AliDismail/Control-Farm/Version 1/brain storming/Instru Project Brain storming.pdf

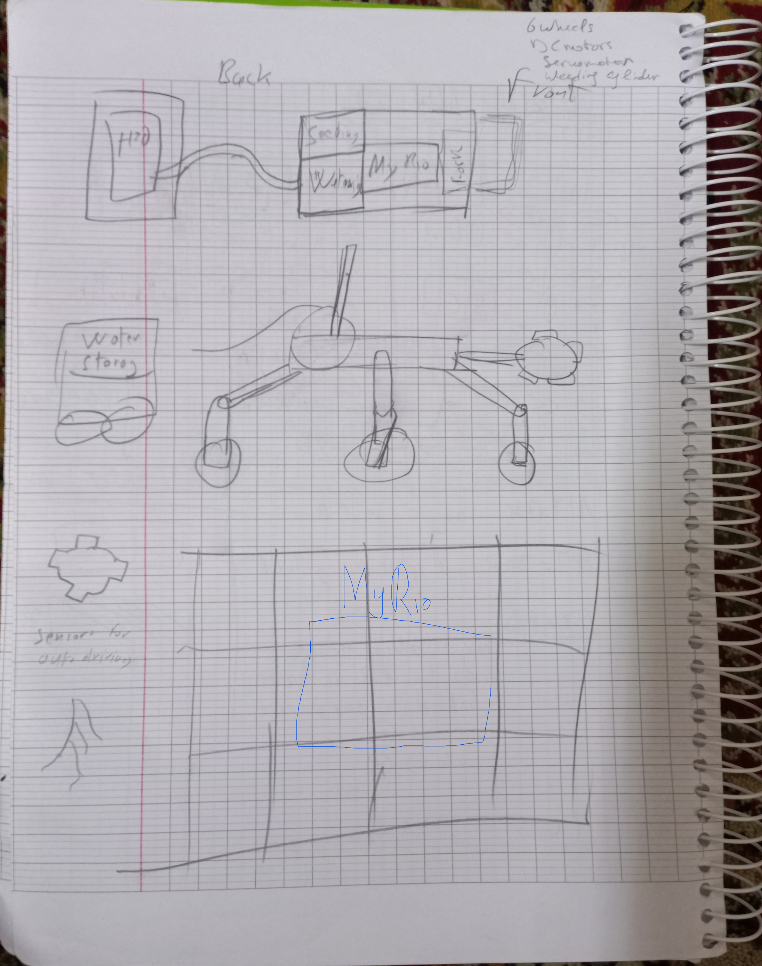
[picture p23: page 1]
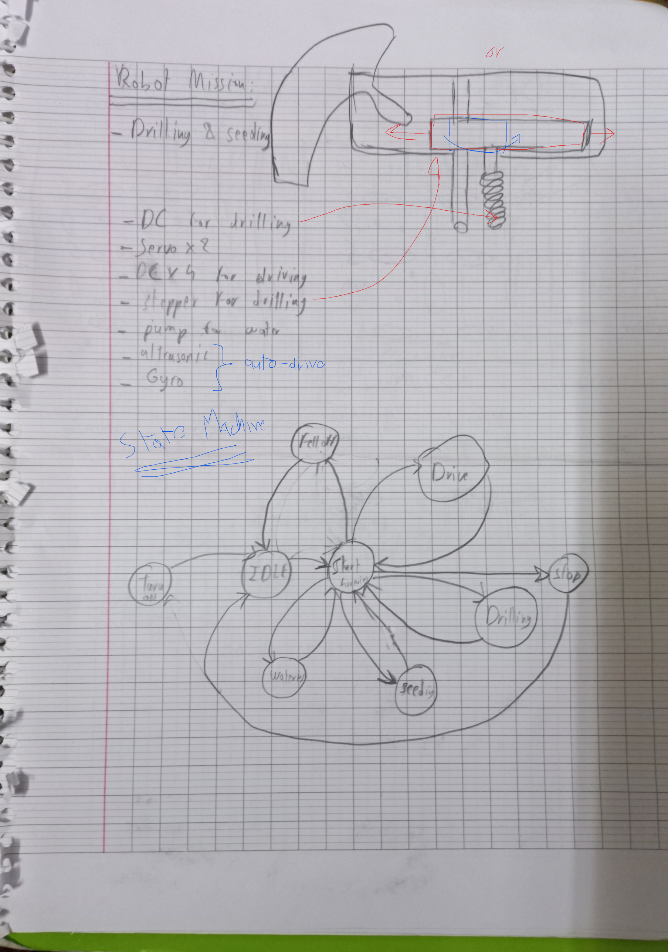
[picture p24: page 2]
