AliDismail/Control-Farm/Version 2/Parts/rest stl/rest stl/Main Gear Shrinked stl.STL

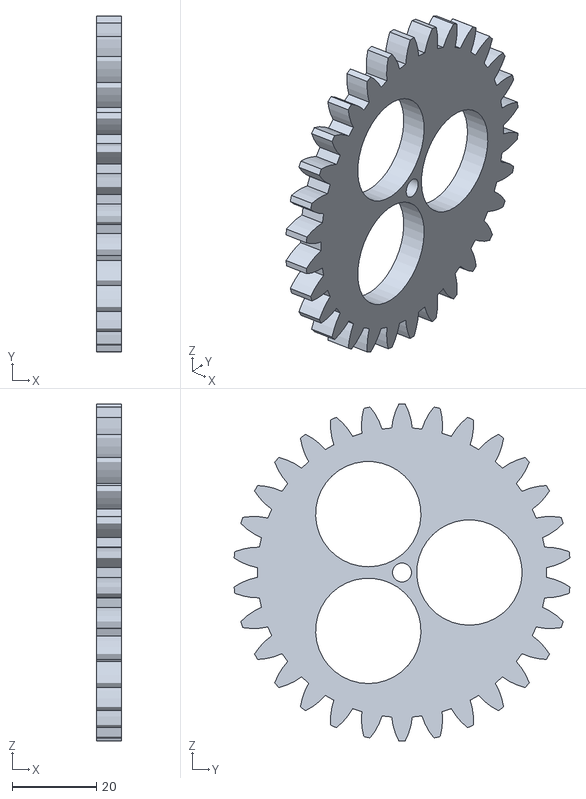
[picture p25: CAD file, 2025-11-14]
Version 2/Parts/rest stl/rest stl/Main Gear Shrinked stl.STL
6.00 x 79.7 x 80.0
