AliDismail/Control-Farm/Version 2/Parts/big/big/Water Stand Shrinked.SLDPRT

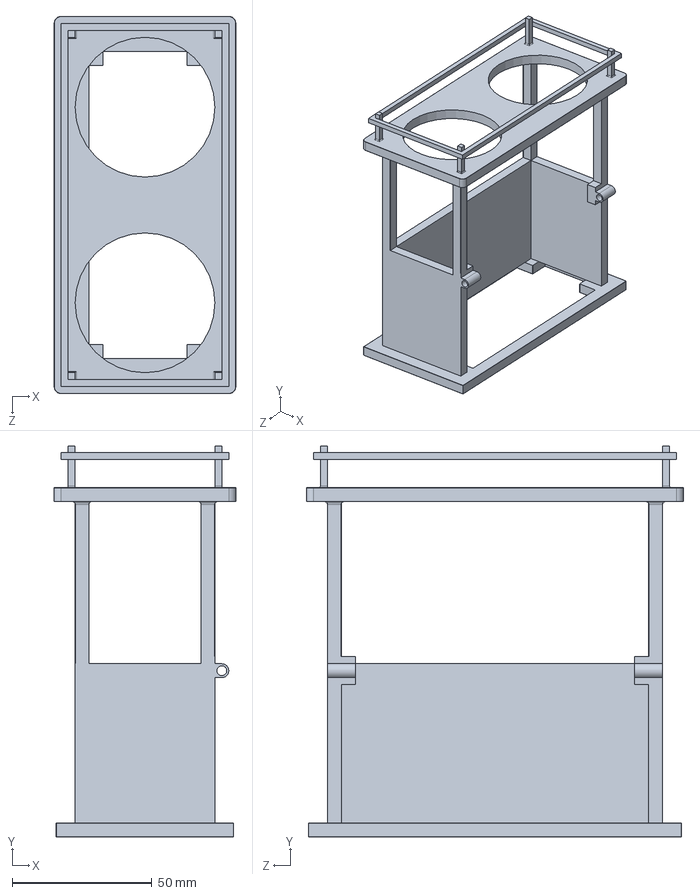
[picture p26: CAD file, 2025-11-14]
Version 2/Parts/big/big/Water Stand Shrinked.SLDPRT
65.0 x 139.9 x 135.0 mm
