AliDismail/Control-Farm/Version 2/Parts/rest stl/rest stl/smallest gear Shrinked stl.STL

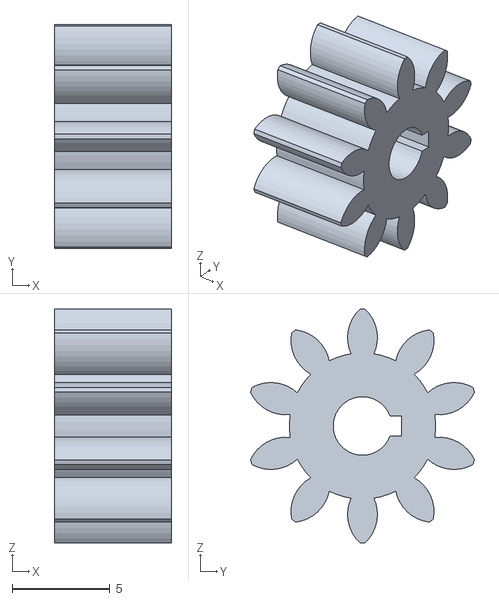
[picture p27: CAD file, 2025-11-14]
Version 2/Parts/rest stl/rest stl/smallest gear Shrinked stl.STL
6.00 x 11.5 x 12.0
