AliDismail/Control-Farm/Version 2/Parts/big/big/Rocker shrinked.SLDPRT

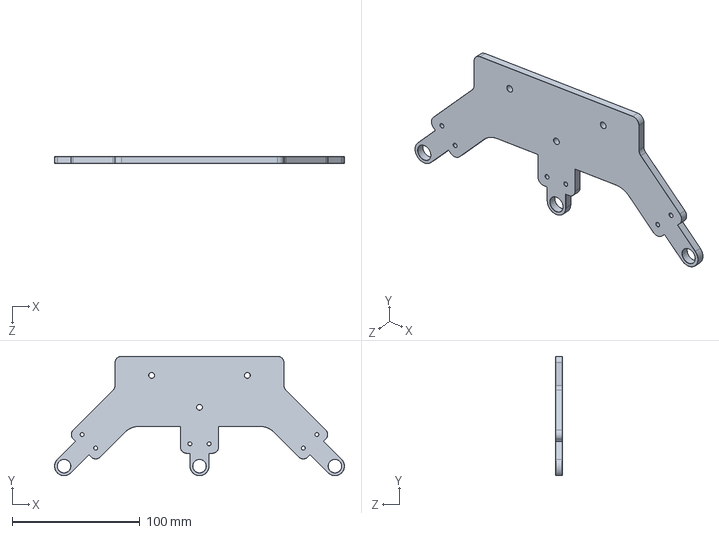
[picture p28: CAD file, 2025-11-14]
Version 2/Parts/big/big/Rocker shrinked.SLDPRT
227.1 x 93.6 x 5.25 mm
