AliDismail/Control-Farm/Version 2/Parts/rest stl/rest stl/Door Shaft Shrinked stl.STL

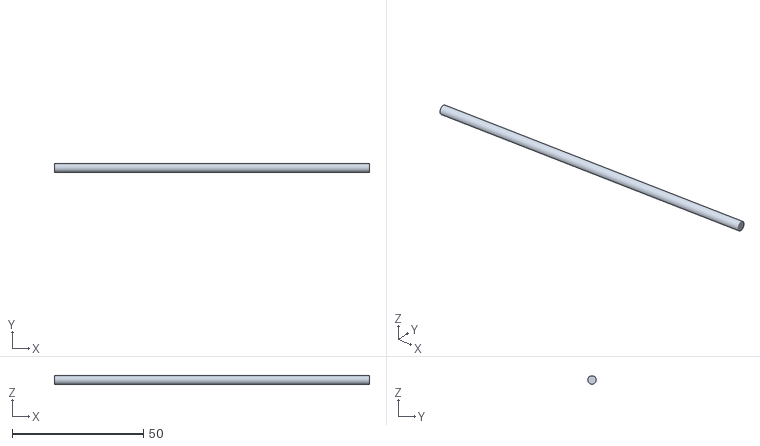
[picture p29: CAD file, 2025-11-14]
Version 2/Parts/rest stl/rest stl/Door Shaft Shrinked stl.STL
120.0 x 3.25 x 3.25
