AliDismail/Control-Farm/Version 2/Parts/big/big/Wheel.SLDPRT

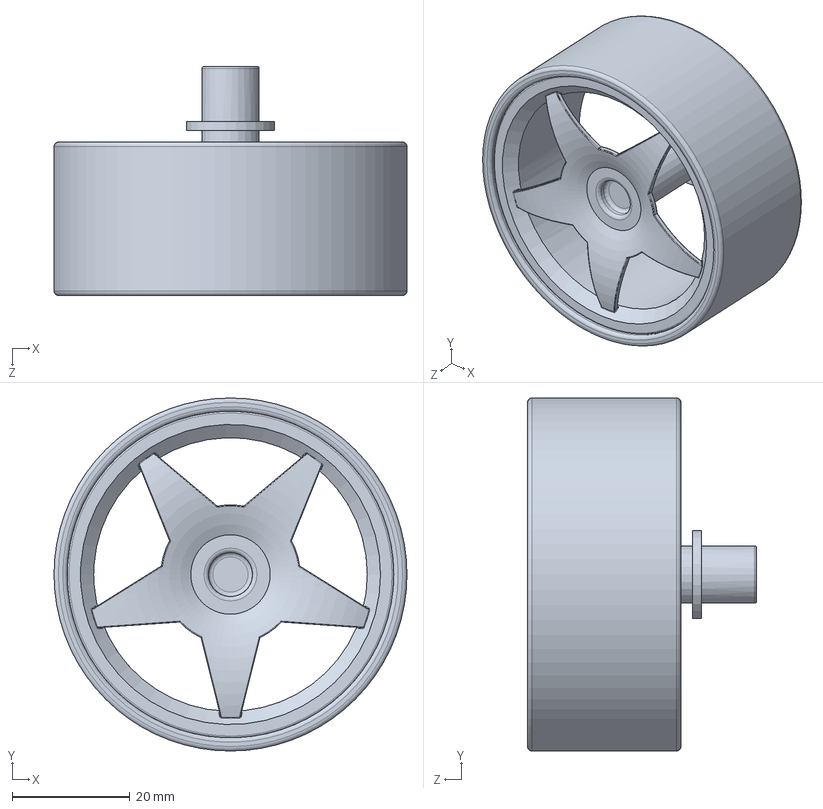
[picture p30: CAD file, 2025-11-14]
Version 2/Parts/big/big/Wheel.SLDPRT
60.0 x 60.0 x 38.9 mm
