AliDismail/Control-Farm/Version 2/Parts/rest stl/rest stl/lower power gear stl.STL

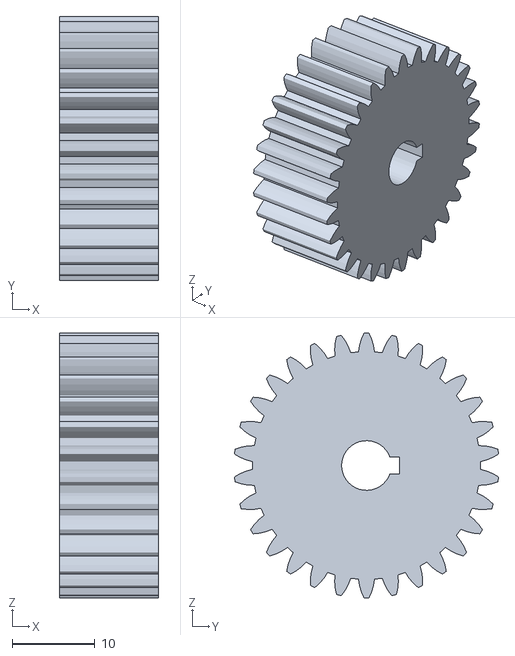
[picture p31: CAD file, 2025-11-14]
Version 2/Parts/rest stl/rest stl/lower power gear stl.STL
12.0 x 31.9 x 32.0
