AliDismail/Control-Farm/Version 2/Parts/big/big/platform base shrinked.SLDPRT

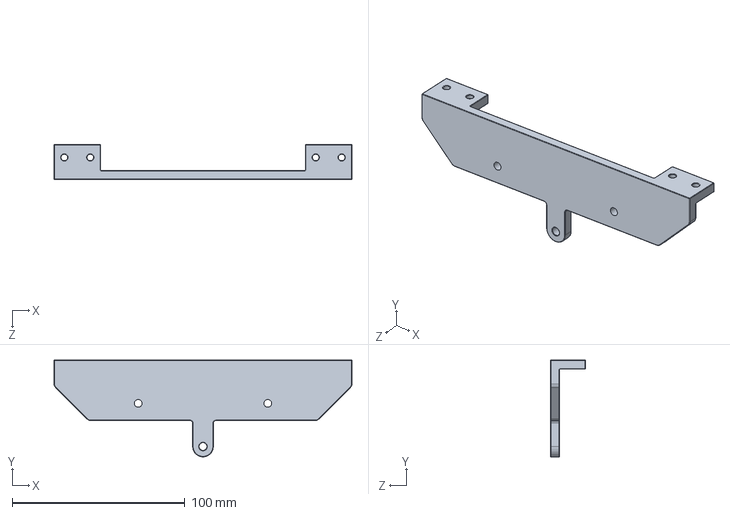
[picture p32: CAD file, 2025-11-14]
Version 2/Parts/big/big/platform base shrinked.SLDPRT
172.5 x 56.0 x 20.2 mm
