AliDismail/Control-Farm/Version 2/Parts/rest stl/rest stl/support gear shrinked stl.STL

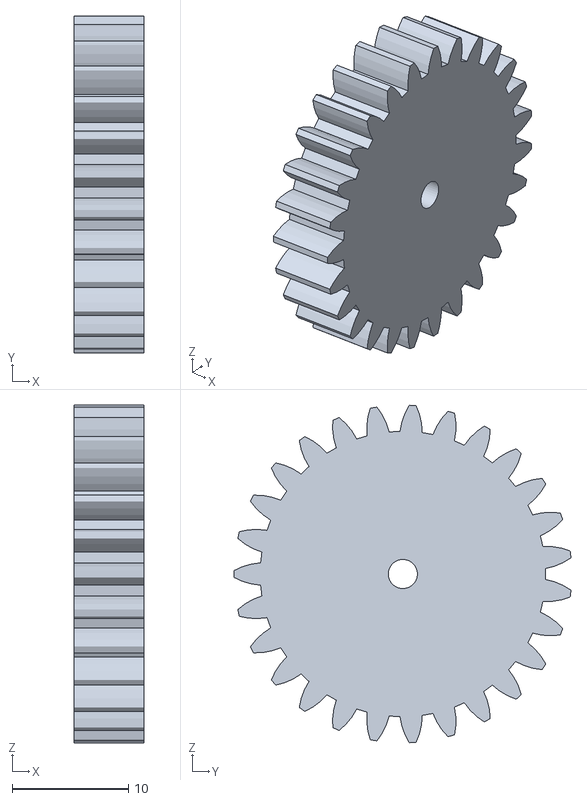
[picture p33: CAD file, 2025-11-14]
Version 2/Parts/rest stl/rest stl/support gear shrinked stl.STL
6.00 x 28.9 x 29.0
