AliDismail/Control-Farm/Version 2/Parts/big/big/platform shrinked.SLDPRT

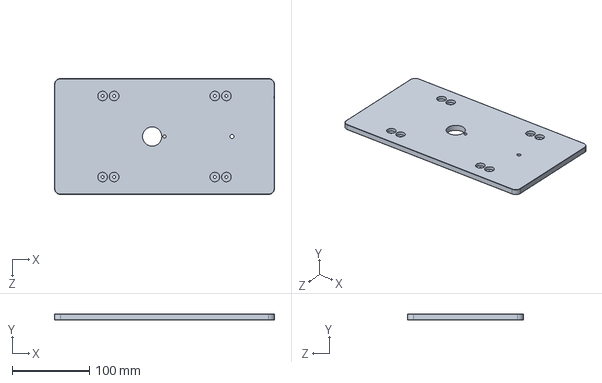
[picture p34: CAD file, 2025-11-14]
Version 2/Parts/big/big/platform shrinked.SLDPRT
285.0 x 7.50 x 150.0 mm
