AliDismail/Control-Farm/Version 2/Parts/rest stl/rest stl/Triangular gear stand shrinked stl.STL

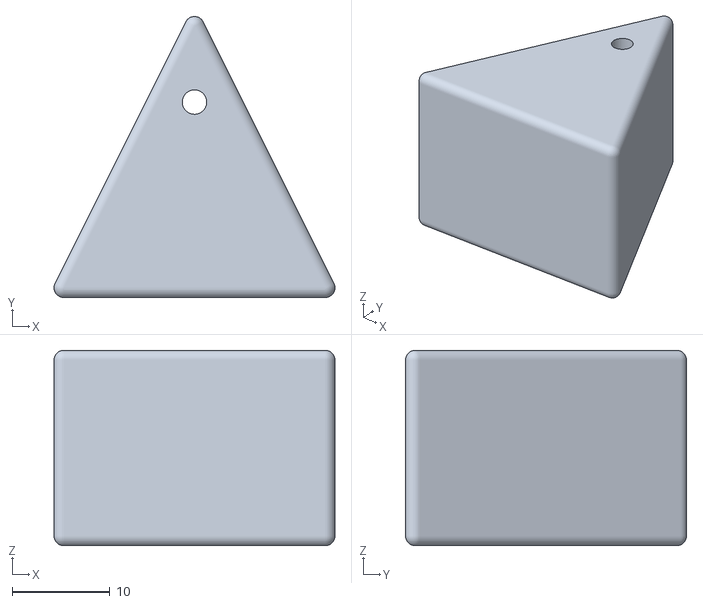
[picture p35: CAD file, 2025-11-14]
Version 2/Parts/rest stl/rest stl/Triangular gear stand shrinked stl.STL
28.8 x 28.8 x 20.0
