AliDismail/Control-Farm/Version 2/Parts/rest stl/rest stl/rack connector shrinked stl.STL

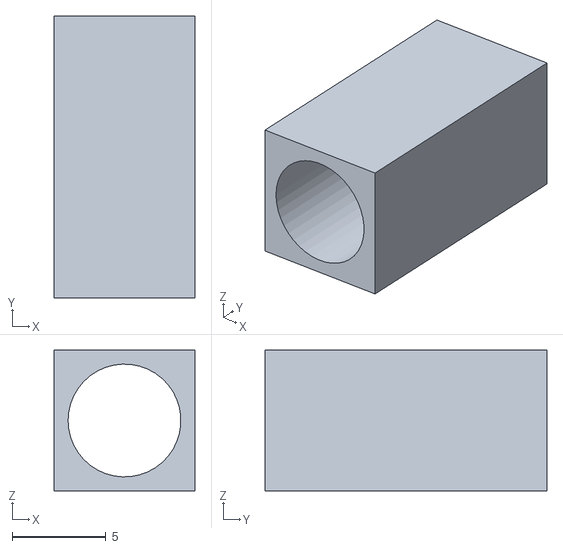
[picture p36: CAD file, 2025-11-14]
Version 2/Parts/rest stl/rest stl/rack connector shrinked stl.STL
7.50 x 15.0 x 7.50
