AliDismail/Control-Farm/Version 2/Parts/rest stl/rest stl/Door Shrinked stl.STL

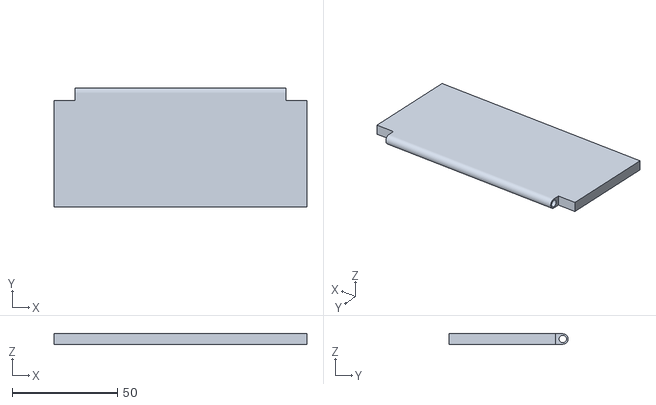
[picture p37: CAD file, 2025-11-14]
Version 2/Parts/rest stl/rest stl/Door Shrinked stl.STL
120.0 x 56.5 x 5.00
