AliDismail/Control-Farm/Version 2/Parts/rest stl/rest stl/Rack Shrinked stl.STL

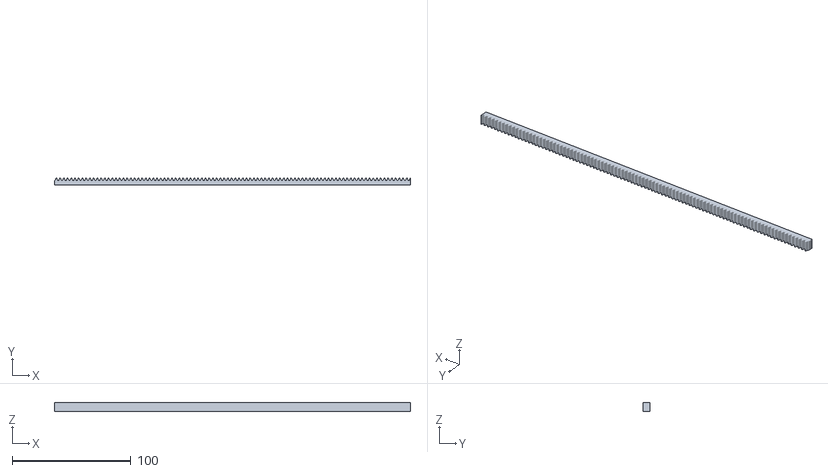
[picture p38: CAD file, 2025-11-14]
Version 2/Parts/rest stl/rest stl/Rack Shrinked stl.STL
300.0 x 6.00 x 7.50
