AliDismail/Control-Farm/Version 2/Parts/rest stl/rest stl/tank gear platform shrinked stl.STL

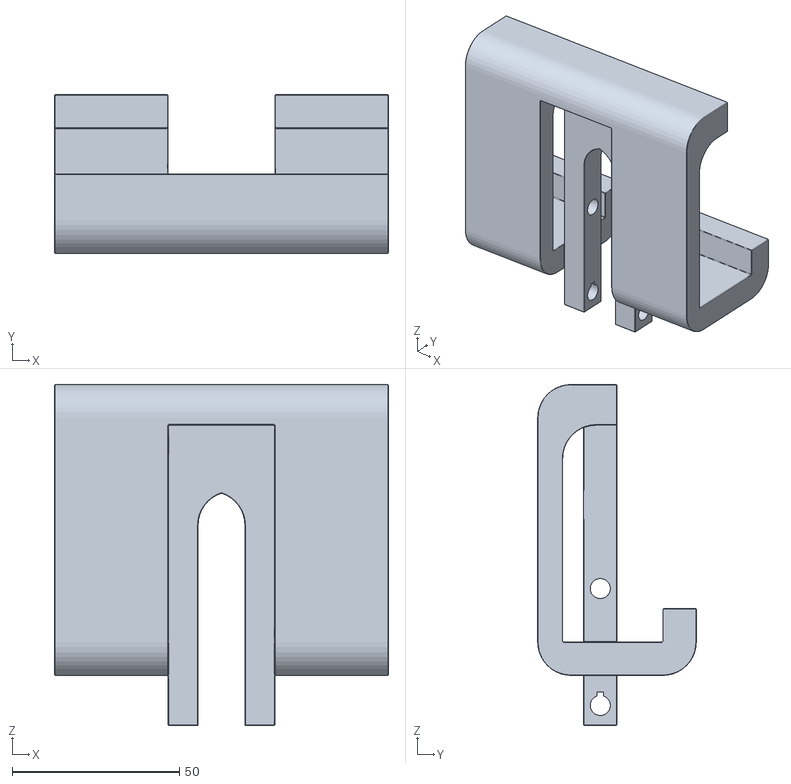
[picture p39: CAD file, 2025-11-14]
Version 2/Parts/rest stl/rest stl/tank gear platform shrinked stl.STL
100.0 x 47.5 x 102.1
