AliDismail/Control-Farm/Version 2/Parts/rest stl/rest stl/Gear opposing smallest Shrinked stl.STL

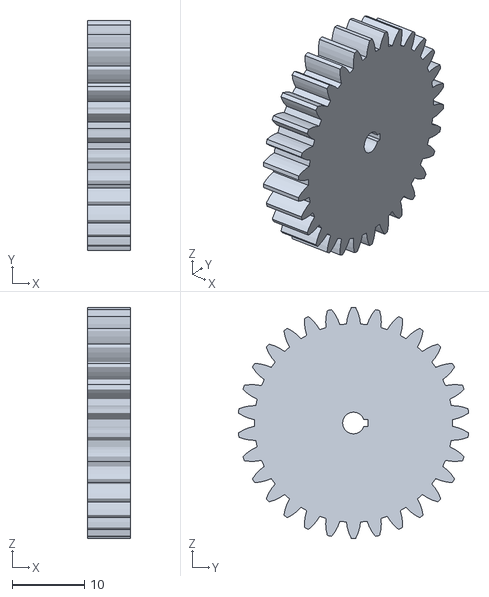
[picture p40: CAD file, 2025-11-14]
Version 2/Parts/rest stl/rest stl/Gear opposing smallest Shrinked stl.STL
6.00 x 31.9 x 32.0
