AliDismail/Control-Farm/Version 2/Parts/rest stl/rest stl/Biggest gear Shrinked stl.STL

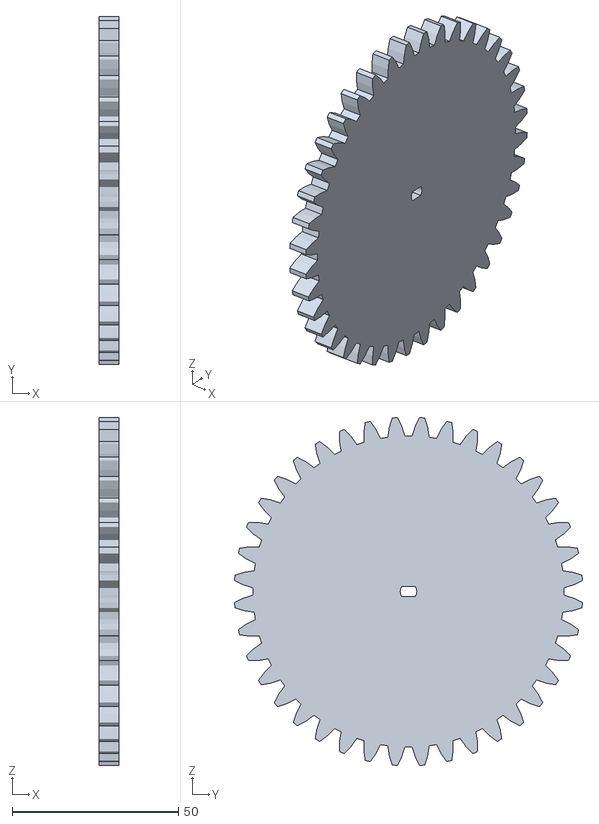
[picture p41: CAD file, 2025-11-14]
Version 2/Parts/rest stl/rest stl/Biggest gear Shrinked stl.STL
6.00 x 104.8 x 104.8
