AliDismail/Control-Farm/Version 2/Parts/rest stl/rest stl/Upper Stand Shrinked stl.STL

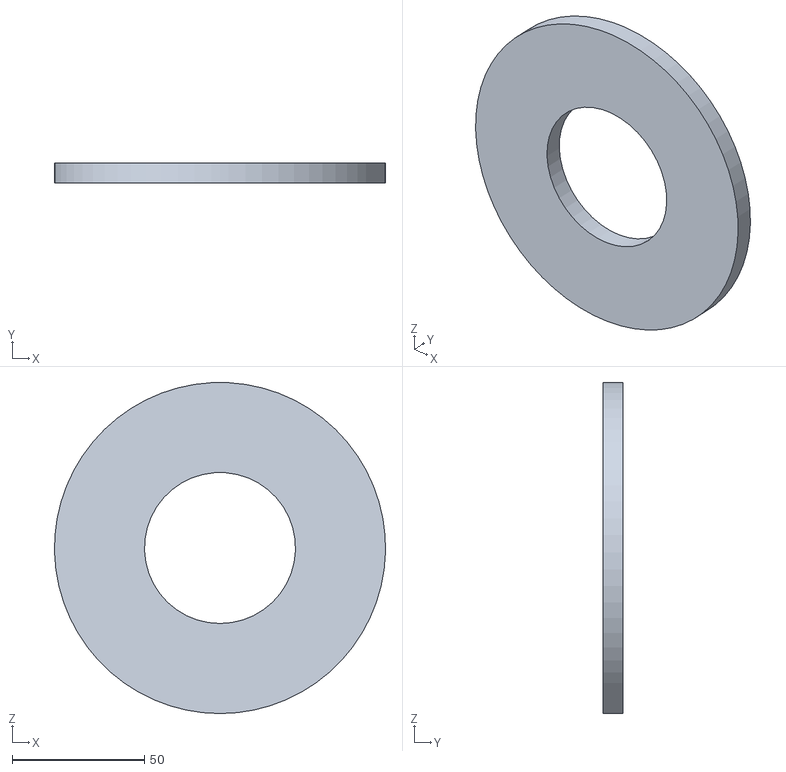
[picture p42: CAD file, 2025-11-14]
Version 2/Parts/rest stl/rest stl/Upper Stand Shrinked stl.STL
125.0 x 7.50 x 125.0
