AliDismail/Control-Farm/Version 2/Parts/rest stl/rest stl/Lower Stand Shrinked stl.STL

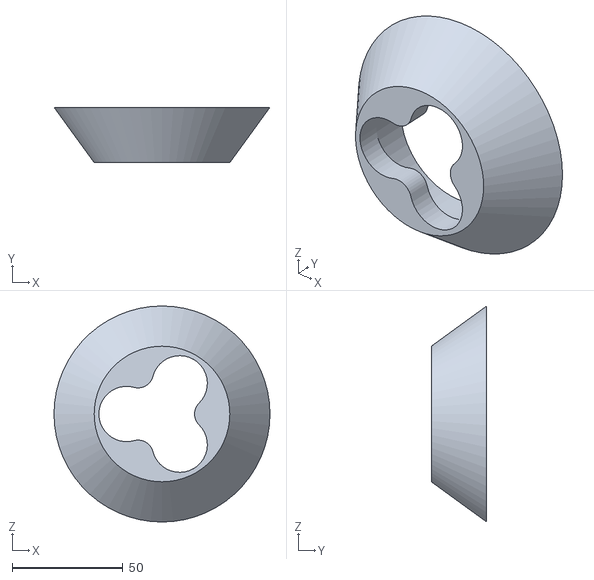
[picture p43: CAD file, 2025-11-14]
Version 2/Parts/rest stl/rest stl/Lower Stand Shrinked stl.STL
97.6 x 25.0 x 97.6
