AliDismail/Control-Farm/Version 2/Parts/rest stl/rest stl/Double Gear Shaft Shrinked stl.STL

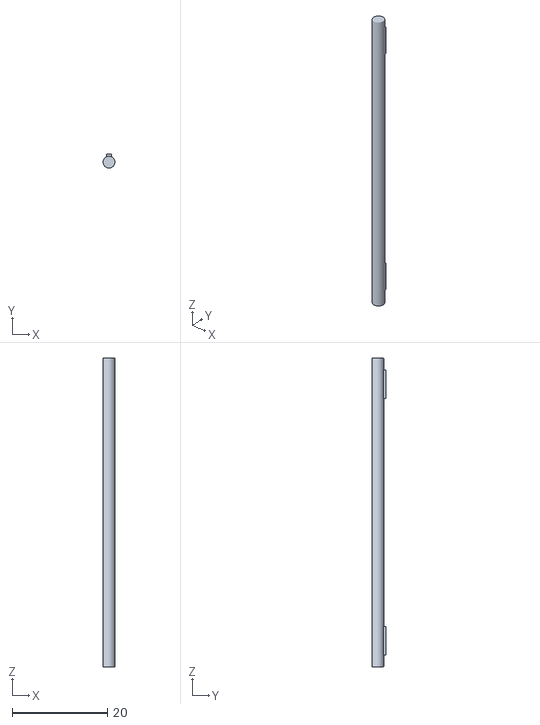
[picture p44: CAD file, 2025-11-14]
Version 2/Parts/rest stl/rest stl/Double Gear Shaft Shrinked stl.STL
2.50 x 2.98 x 65.0
