AliDismail/Control-Farm/Version 2/Parts/rest stl/rest stl/DC motor link stl.STL

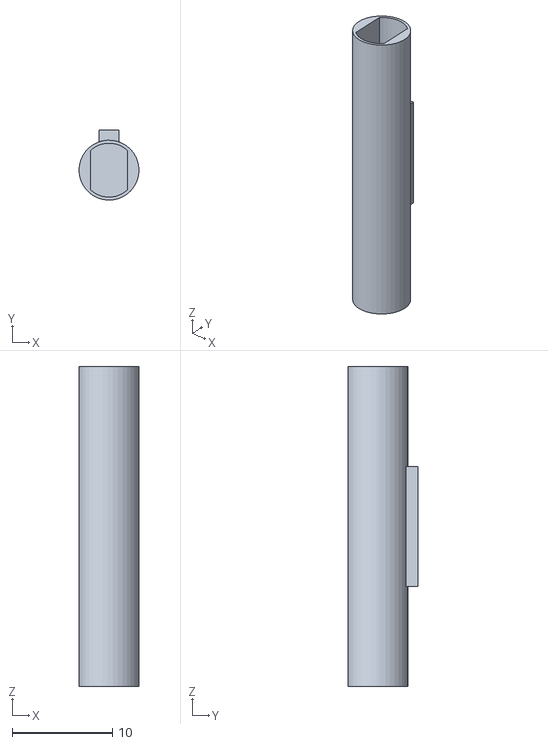
[picture p45: CAD file, 2025-11-14]
Version 2/Parts/rest stl/rest stl/DC motor link stl.STL
6.00 x 7.03 x 32.0
