AliDismail/Control-Farm/Version 2/Parts/rest stl/rest stl/power geaar shaft stl.STL

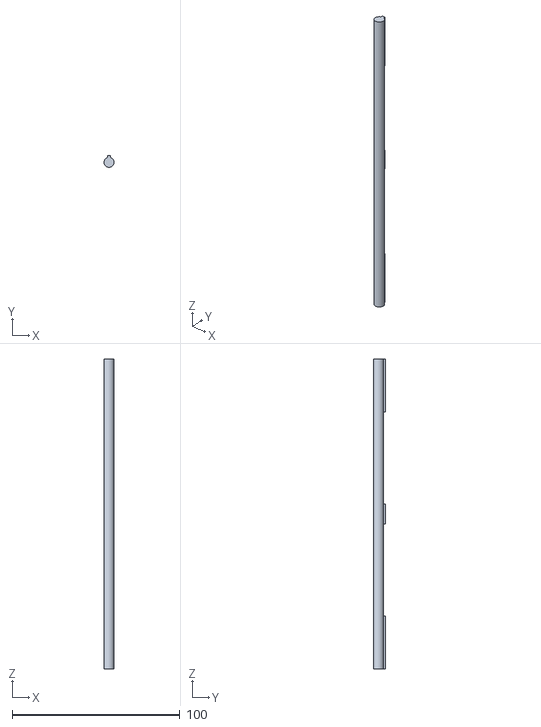
[picture p46: CAD file, 2025-11-14]
Version 2/Parts/rest stl/rest stl/power geaar shaft stl.STL
5.99 x 7.03 x 185.0
