AliDismail/Control-Farm/Version 2/Parts/rest stl/rest stl/Gear connected to motor Shrinked stl.STL

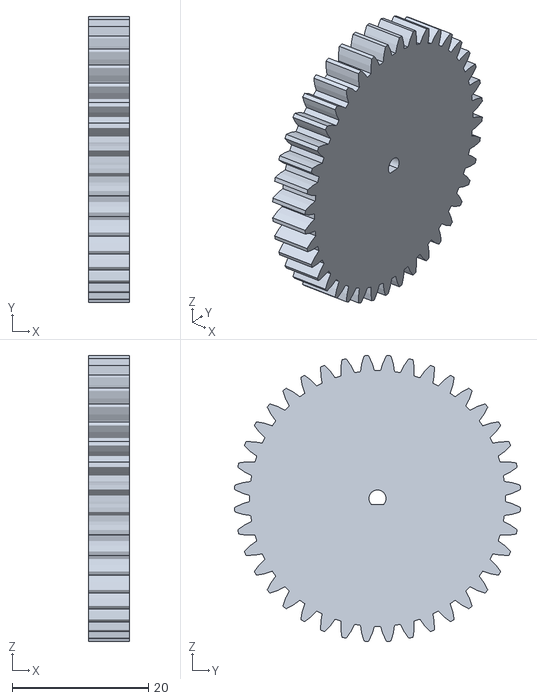
[picture p47: CAD file, 2025-11-14]
Version 2/Parts/rest stl/rest stl/Gear connected to motor Shrinked stl.STL
6.00 x 41.9 x 41.9
