AliDismail/Control-Farm/Version 2/Parts/rest stl/rest stl/middle gear shaft shrinked stl.STL

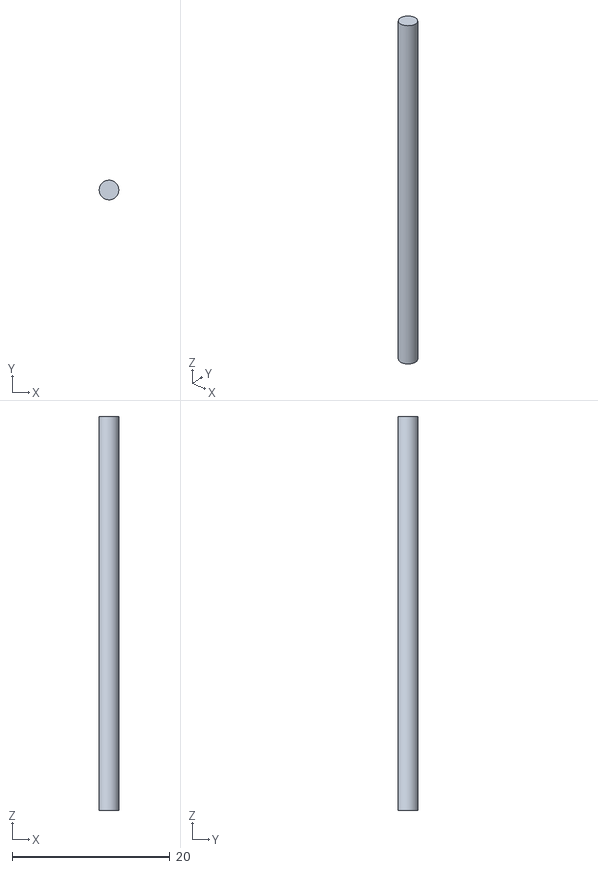
[picture p48: CAD file, 2025-11-14]
Version 2/Parts/rest stl/rest stl/middle gear shaft shrinked stl.STL
2.50 x 2.50 x 50.0
