AliDismail/Control-Farm/Version 2/Parts/rest stl/rest stl/top power gear stl.STL

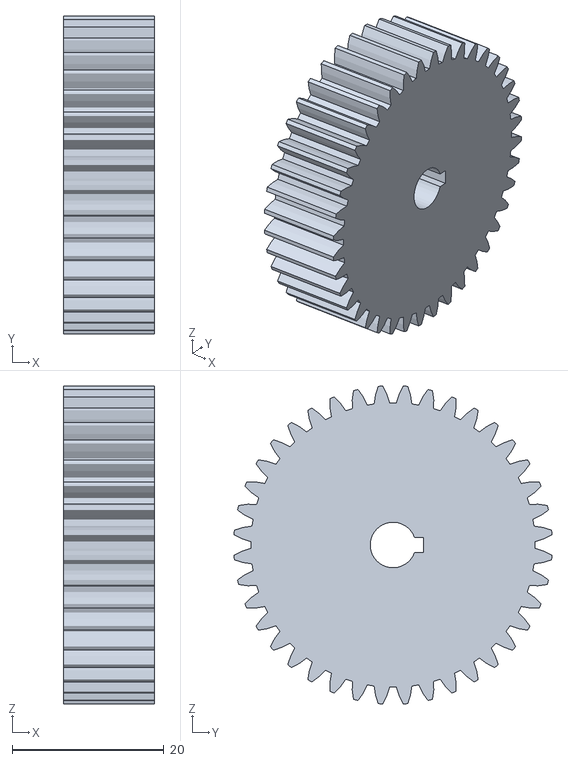
[picture p49: CAD file, 2025-11-14]
Version 2/Parts/rest stl/rest stl/top power gear stl.STL
12.0 x 41.9 x 41.9
