AliDismail/Control-Farm/Version 2/Parts/rest stl/rest stl/Middle Gear Shrinked stl.STL

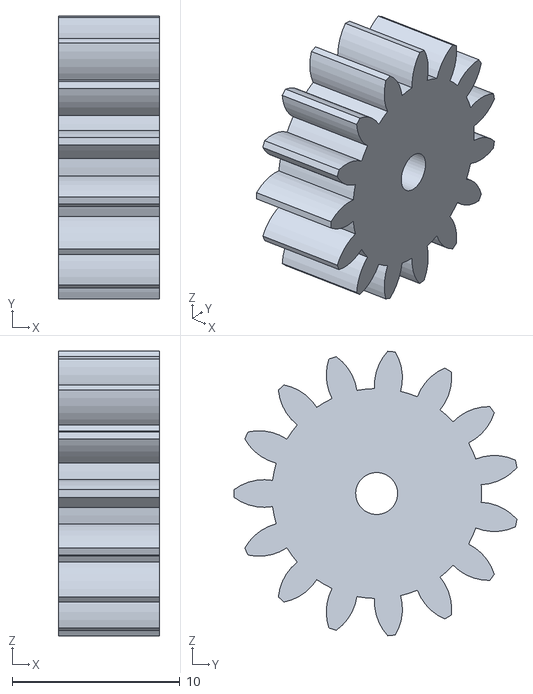
[picture p50: CAD file, 2025-11-14]
Version 2/Parts/rest stl/rest stl/Middle Gear Shrinked stl.STL
6.00 x 16.9 x 16.9
