AliDismail/Control-Farm/Version 2/Parts/rest stl/rest stl/Bearing Shrinked stl.STL

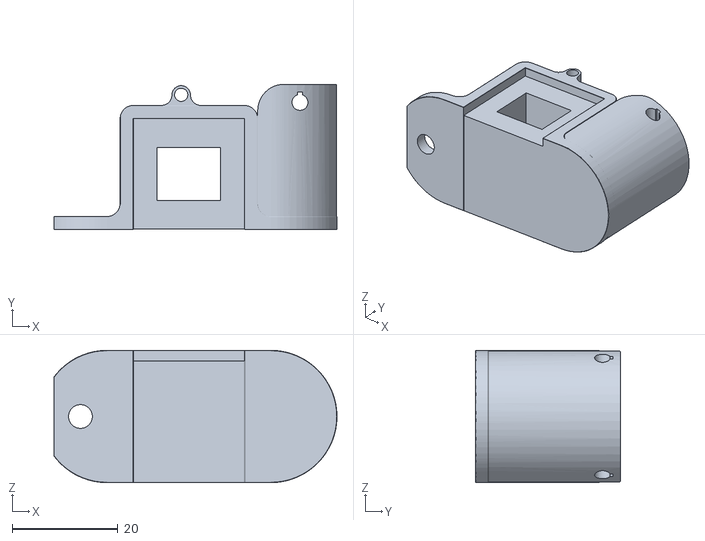
[picture p51: CAD file, 2025-11-14]
Version 2/Parts/rest stl/rest stl/Bearing Shrinked stl.STL
53.5 x 27.5 x 25.0
