AliDismail/Control-Farm/Version 2/Parts/rest stl/rest stl/wheel seal stl.STL

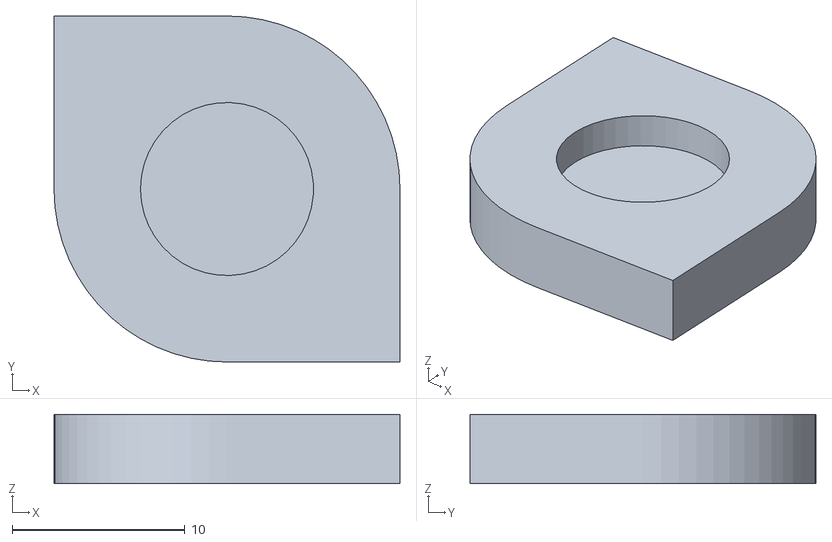
[picture p52: CAD file, 2025-11-14]
Version 2/Parts/rest stl/rest stl/wheel seal stl.STL
20.0 x 20.0 x 4.00
